DejanVasic/Gen3-Trip-Logger/app/src/main/ic_launcher-playstore.png

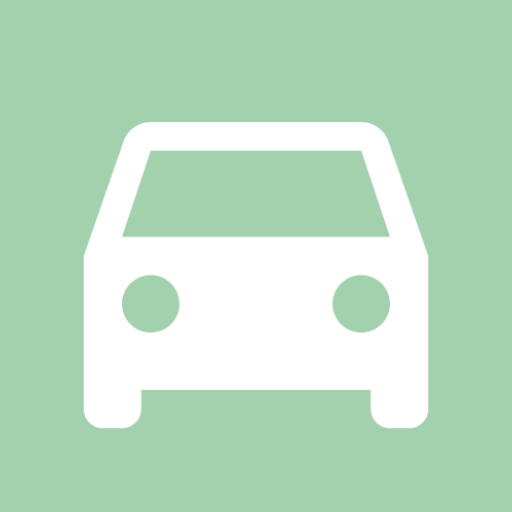
app/src/main/ic_launcher-playstore.png
