DejanVasic/Gen3-Trip-Logger/hardware/protoboard back.jpg

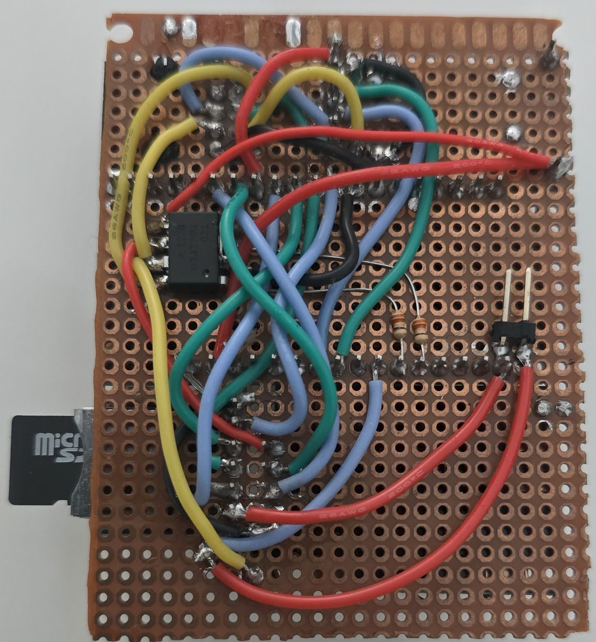
hardware/protoboard back.jpg
