DejanVasic/Gen3-Trip-Logger/hardware/protoboard top.jpg

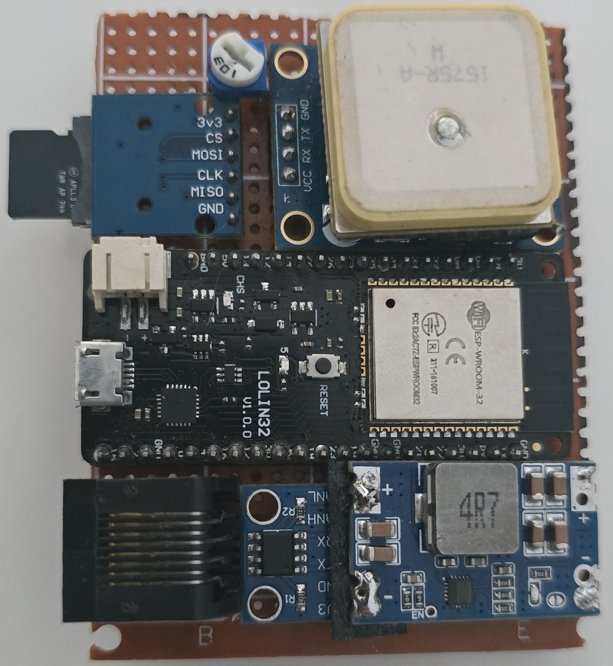
hardware/protoboard top.jpg
