DejanVasic/Gen3-Trip-Logger/(list of files, drawings)

Other design files:
hardware/EasyEDA.json
