DejanVasic/Gen3-Trip-Logger/(commit log)

2025-09-30 work in progress
    [EasyEDA.json]
2026-04-29 added battery blocks indicator, current etc
2026-06-22 HV battery column fix
